stan23/tww-control/PCB/tww/tww_schematic_v1.1.pdf

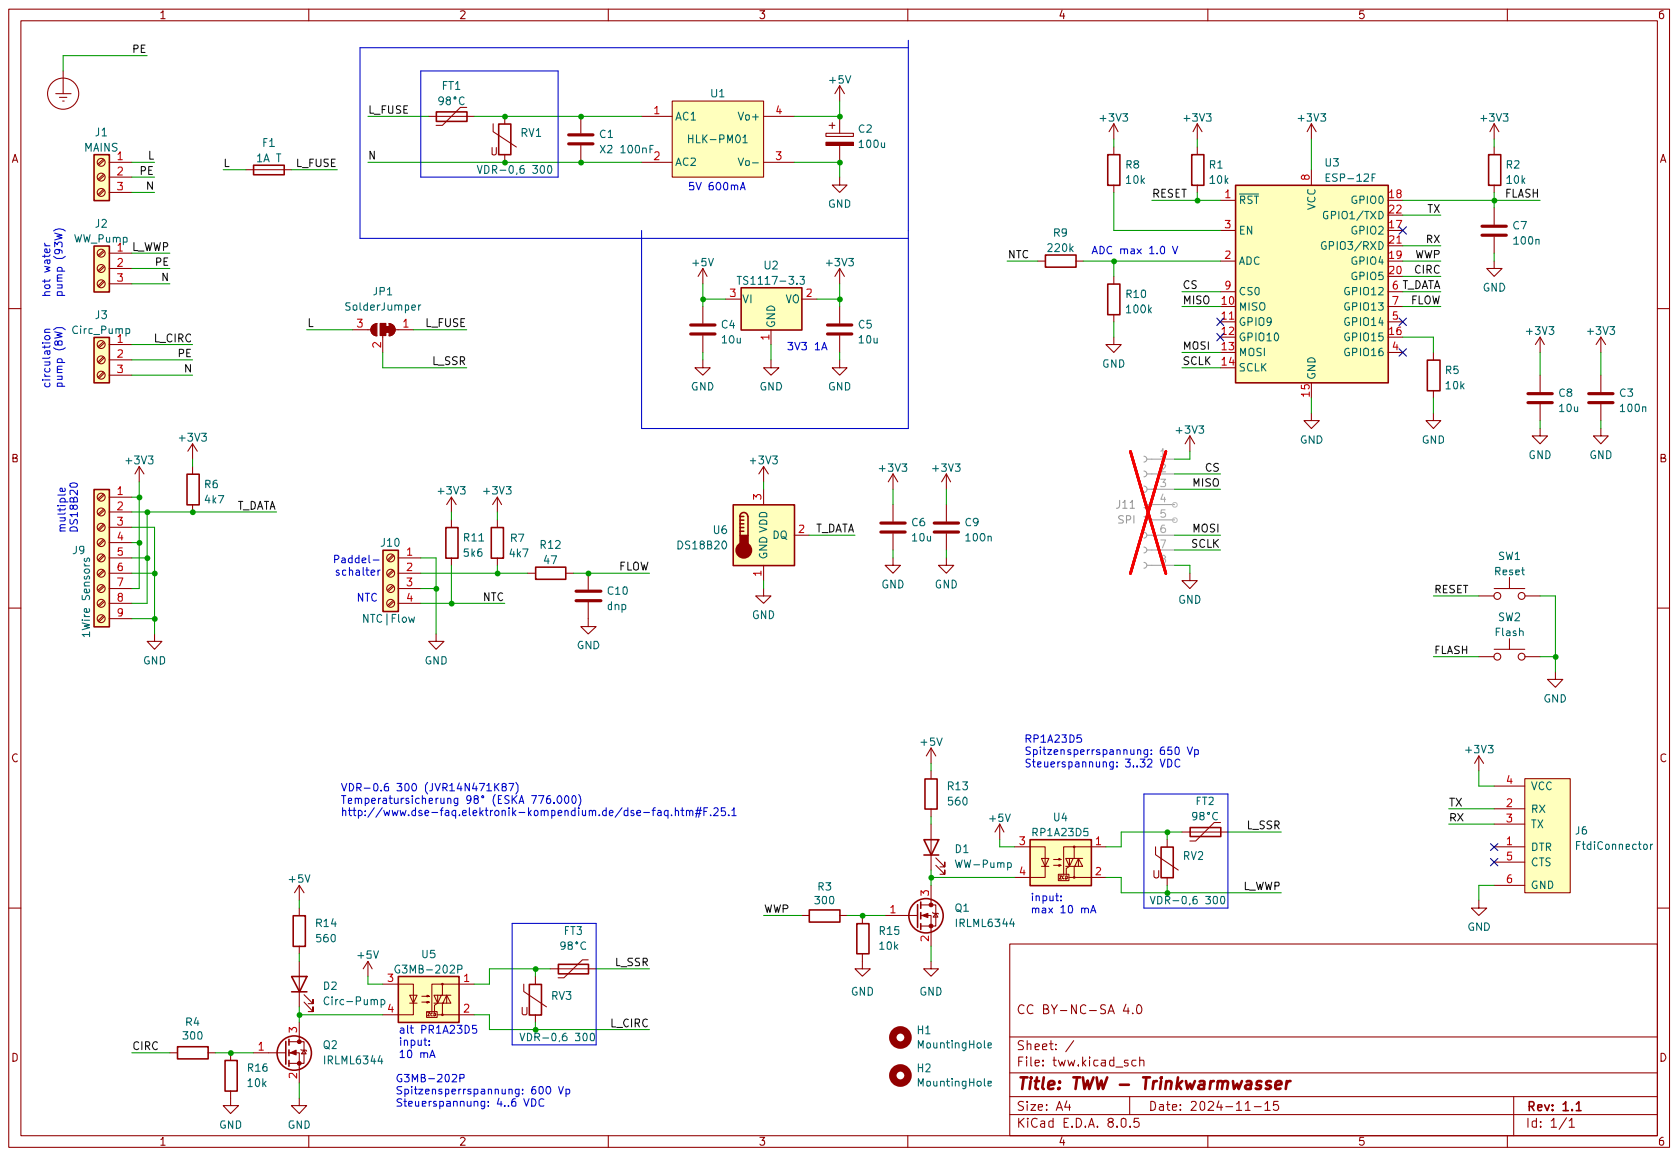
[picture p1: page 1]
