stan23/tww-control/PCB/tww/tww_pcb_bottom_v1.1.pdf

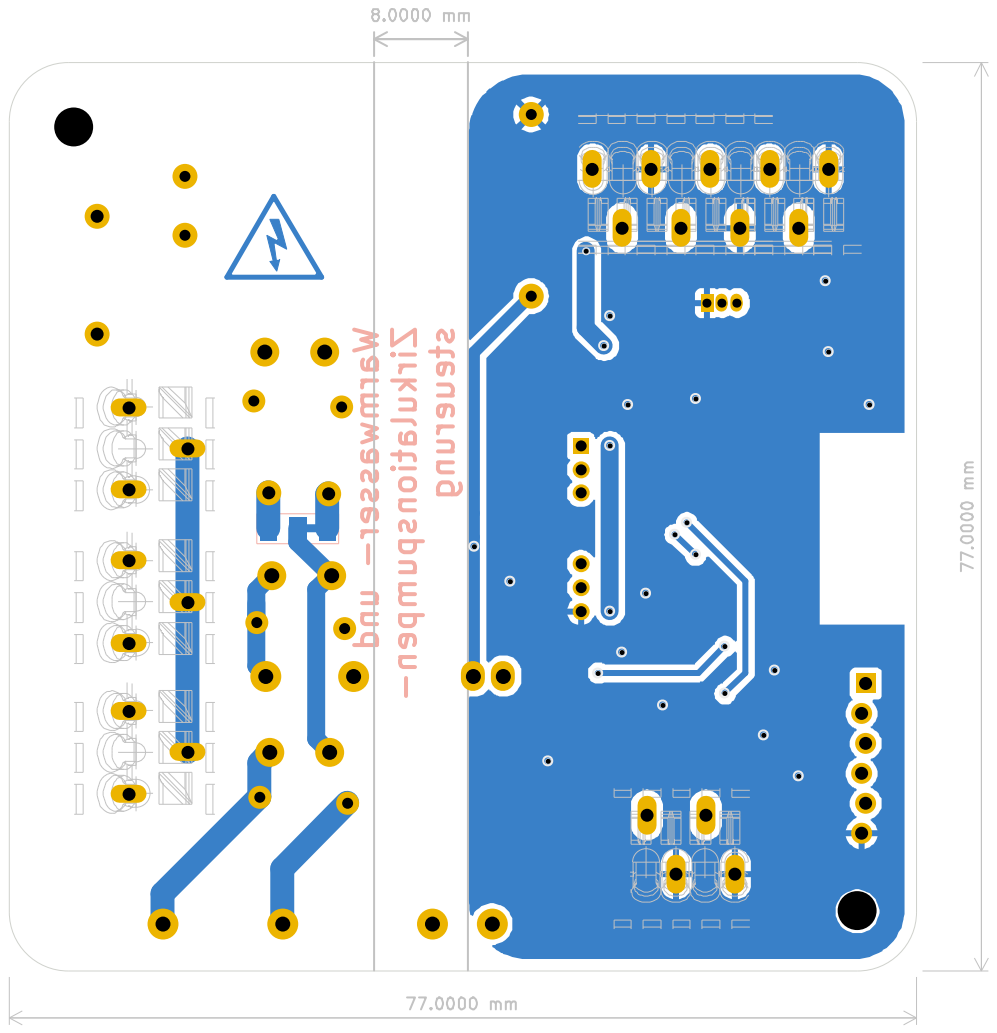
[picture p2: page 1]
