stan23/tww-control/PCB/tww/tww_pcb_top_v1.1.pdf

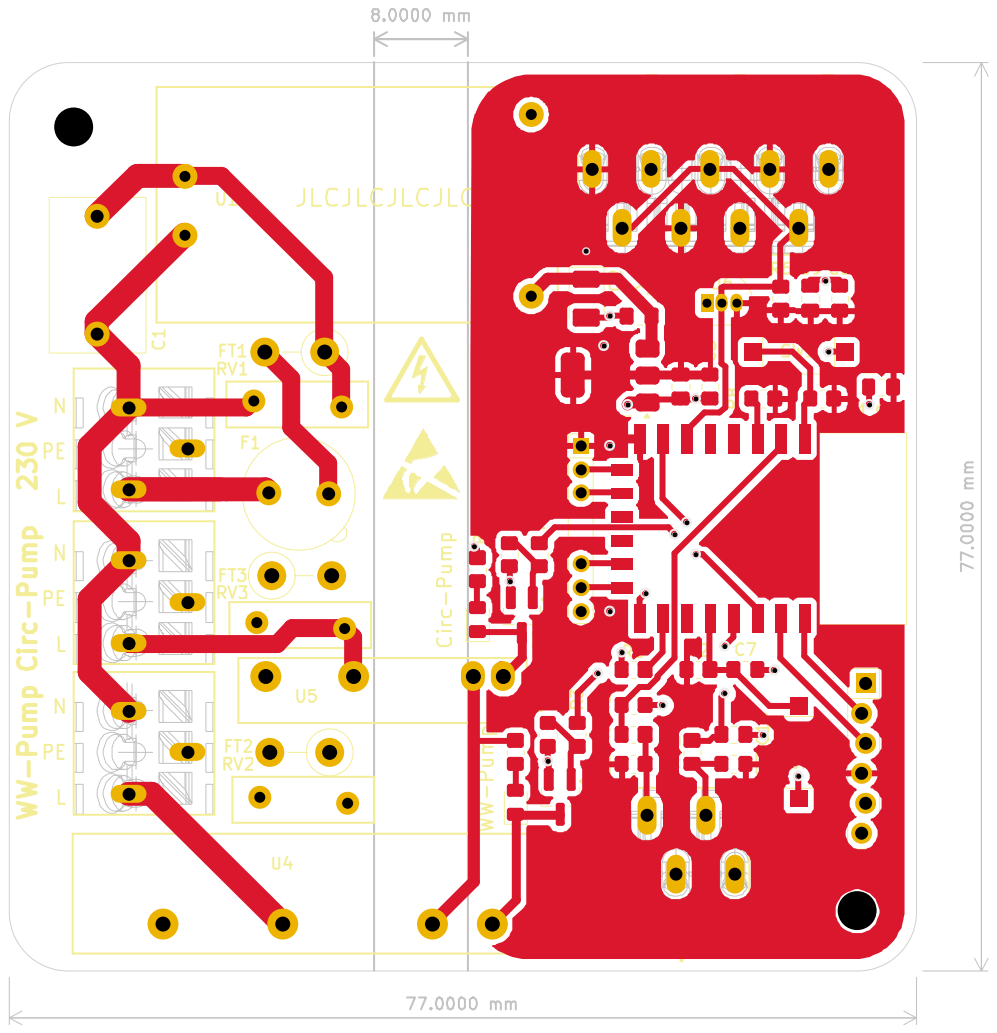
[picture p3: page 1]
