stan23/tww-control/PCB/tww/tww_schematic_v1.0.pdf

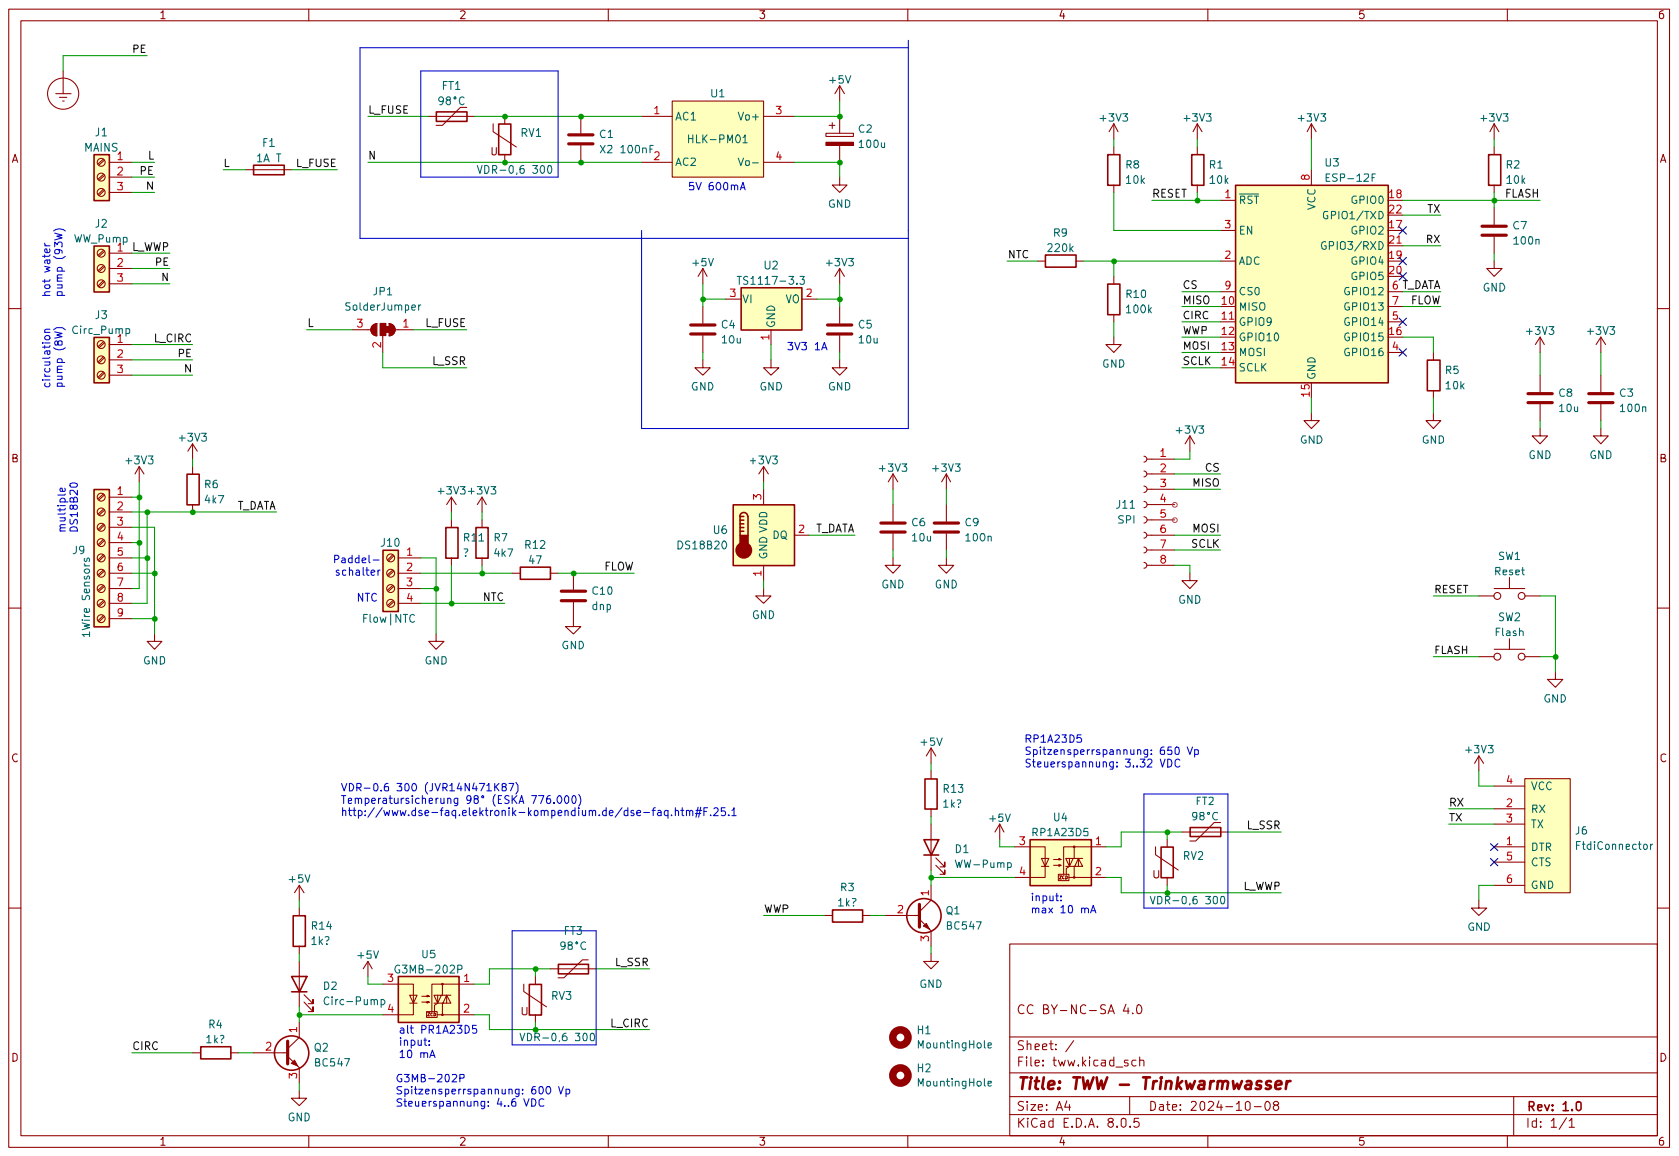
[picture p4: page 1]
