stan23/tww-control/PCB/tww/tww_pcb_bottom_v1.0.pdf

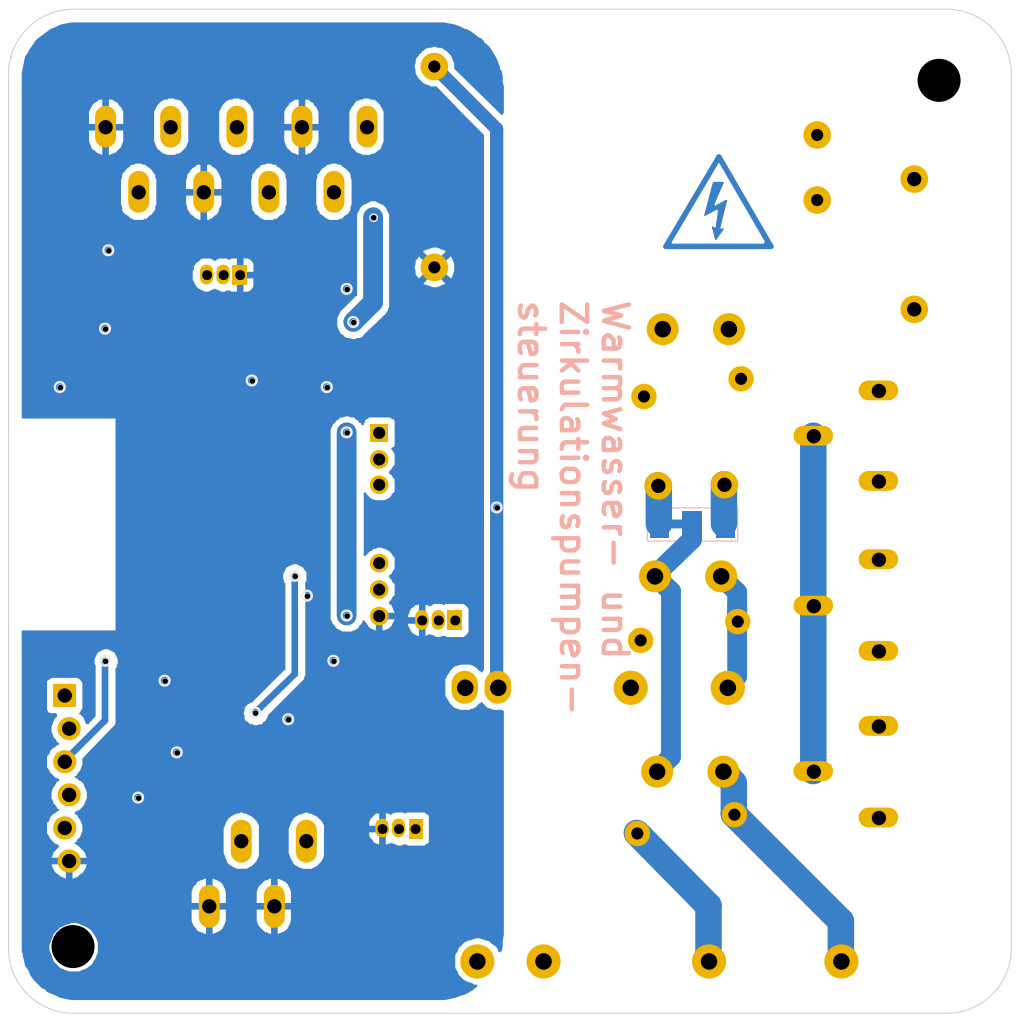
[picture p5: page 1]
