stan23/tww-control/PCB/tww/tww_pcb_top_v1.0.pdf

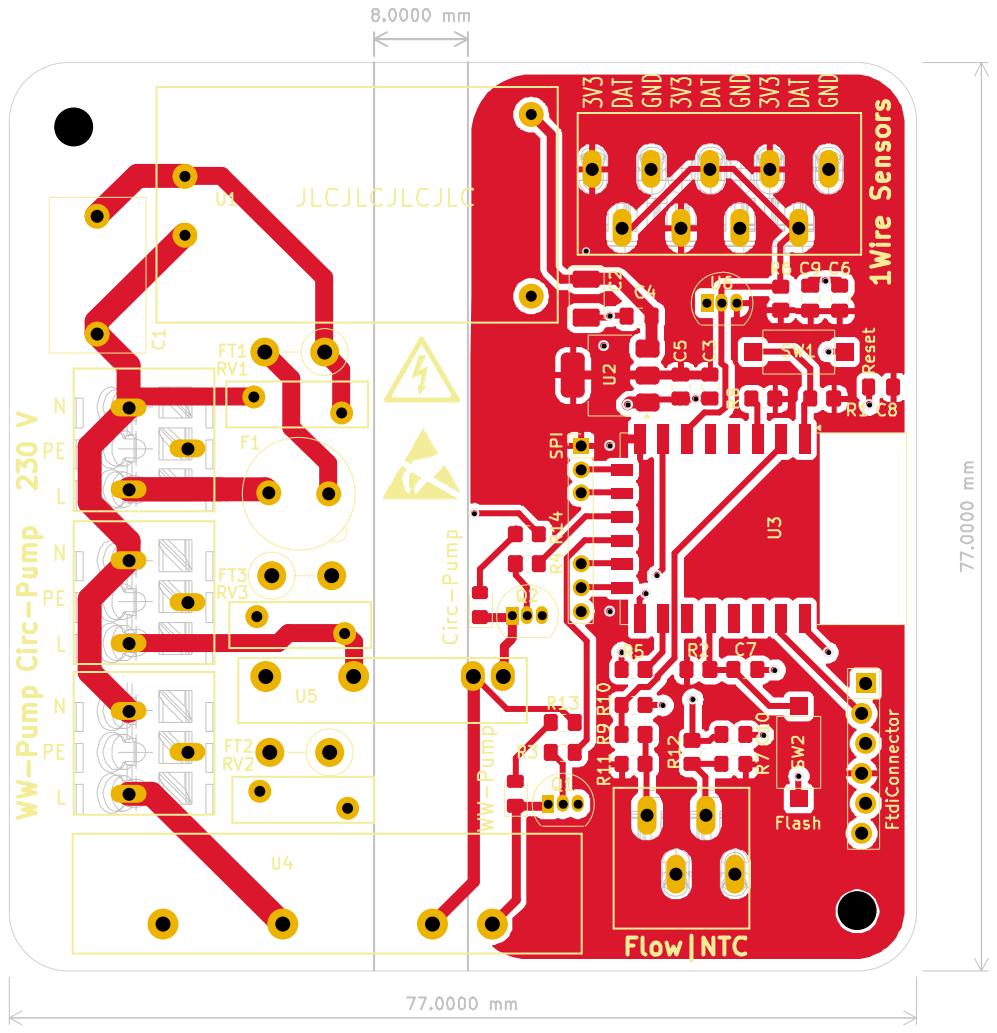
[picture p6: page 1]
