stan23/tww-control/PCB/tww/tww.kicad_pcb

## KiCad design PCB/tww/tww.kicad_pcb (2024-11-15)

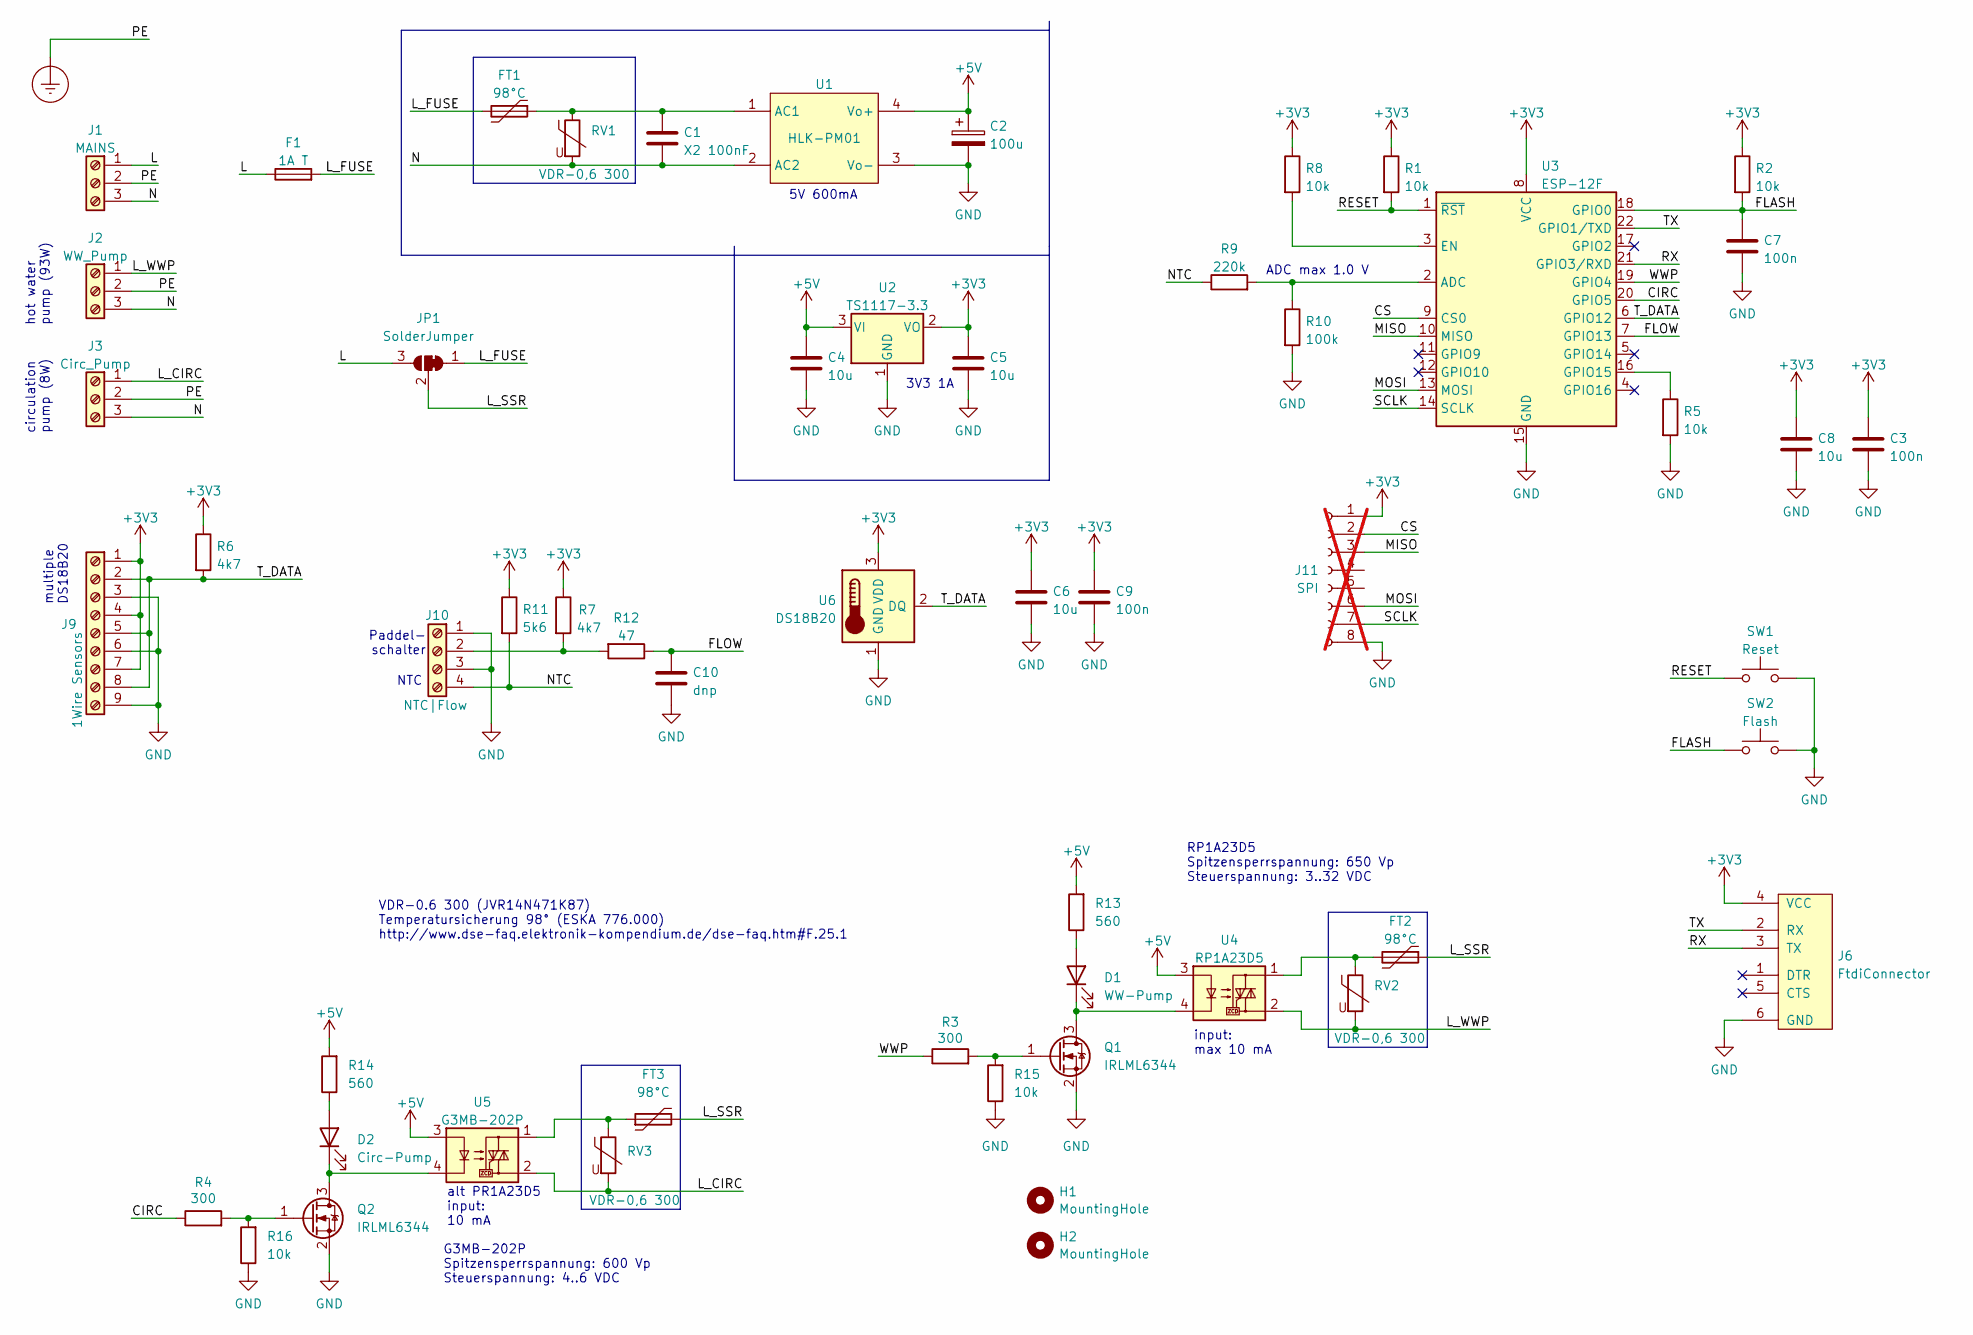
[picture p7: schematic tww.kicad_sch, TWW - Trinkwarmwasser]

Parts:
C1: X2 100nF; C_Rect_L13.0mm_W8.0mm_P10.00mm_FKS3_FKP3_MKS4
C2: 100u; CP_EIA-3528-12_Kemet-T_Pad1.50x2.35mm_HandSolder
C3, C7, C9: 100n; C_0805_2012Metric_Pad1.18x1.45mm_HandSolder
C4, C5, C6, C8: 10u; C_0805_2012Metric_Pad1.18x1.45mm_HandSolder
C10: dnp; C_0805_2012Metric_Pad1.18x1.45mm_HandSolder
D1: WW-Pump; LED_0805_2012Metric_Pad1.15x1.40mm_HandSolder
D2: Circ-Pump; LED_0805_2012Metric_Pad1.15x1.40mm_HandSolder
F1: 1A T; Fuseholder_TR5_Littelfuse_No560_No460
FT1, FT2, FT3: 98°C; R_Axial_DIN0411_L9.9mm_D3.6mm_P5.08mm_Vertical
H1, H2: MountingHole; MountingHole_3.2mm_M3
J1: MAINS; P-250-203
J2: WW_Pump; P-250-203
J3: Circ_Pump; P-250-203
J6: FtdiConnector; Pin_Header_Straight_1x06_Pitch2.54mm_Tight_Fit
J9: 1Wire Sensors; P-250-409
J10: NTC|Flow; P-250-404
J11: SPI; PinHeader_1x08_P2.00mm_Vertical; not fitted
JP1: SolderJumper; SolderJumper-3_P1.3mm_Bridged12_Pad1.0x1.5mm
Q1, Q2: IRLML6344; SOT-23_Handsoldering
R1, R2, R5, R8, R15, R16: 10k; R_0805_2012Metric_Pad1.20x1.40mm_HandSolder
R3, R4: 300; R_0805_2012Metric_Pad1.20x1.40mm_HandSolder
R6, R7: 4k7; R_0805_2012Metric_Pad1.20x1.40mm_HandSolder
R9: 220k; R_0805_2012Metric_Pad1.20x1.40mm_HandSolder
R10: 100k; R_0805_2012Metric_Pad1.20x1.40mm_HandSolder
R11: 5k6; R_0805_2012Metric_Pad1.20x1.40mm_HandSolder
R12: 47; R_0805_2012Metric_Pad1.20x1.40mm_HandSolder
R13, R14: 560; R_0805_2012Metric_Pad1.20x1.40mm_HandSolder
RV1, RV2, RV3: VDR-0,6 300; RV_Disc_D12mm_W3.9mm_P7.5mm
SW1: Reset; SW_SPST_CK_RS282G05A3
SW2: Flash; SW_SPST_CK_RS282G05A3
U1: HLK-PM01; Hi-Link_HLK-PMxx
U2: TS1117-3.3; SOT-223-3_TabPin2
U3: ESP-12F; ESP-12E
U4: RP1A23D5; Carlo_Gavazzi_RP1A
U5: G3MB-202P; Omron_G3MB
U6: DS18B20; TO-92_Inline

Connections:
+3V3: C3.1, C5.1, C6.1, C8.1, C9.1, J6.4 (VCC), J9.1, J9.4, J9.7, J11.1, R1.1, R2.1, R6.1, R7.1, R8.1, R11.1, U2.2 (VO), U3.8 (VCC), U6.3 (VDD)
+5V: C2.1, C4.1, R13.2, R14.2, U1.4 (Vo+), U2.3 (VI), U4.3, U5.3
/CIRC: R4.1, U3.20 (GPIO5)
/CS: J11.2, U3.9 (CS0)
/FLASH: C7.1, R2.2, SW2.1, U3.18 (GPIO0)
/FLOW: C10.1, R12.1, U3.7 (GPIO13)
/L: F1.1, J1.1, JP1.3 (B)
/L_CIRC: J3.1, RV3.2, U5.2
/L_FUSE: F1.2, FT1.2, JP1.1 (A)
/L_SSR: FT2.1, FT3.2, JP1.2 (C)
/L_WWP: J2.1, RV2.2, U4.2
/MISO: J11.3, U3.10 (MISO)
/MOSI: J11.6, U3.13 (MOSI)
/N: C1.2, J1.3, J2.3, J3.3, RV1.2, U1.2 (AC2)
/NTC: J10.4, R9.1, R11.2
/RESET: R1.2, SW1.1, U3.1 (~RST)
/RX: J6.3 (TX), U3.21 (GPIO3/RXD)
/SCLK: J11.7, U3.14 (SCLK)
/TX: J6.2 (RX), U3.22 (GPIO1/TXD)
/T_DATA: J9.2, J9.5, J9.8, R6.2, U3.6 (GPIO12), U6.2 (DQ)
/WWP: R3.1, U3.19 (GPIO4)
Earth_Protective: J1.2, J2.2, J3.2
GND: C2.2, C3.2, C4.2, C5.2, C6.2, C7.2, C8.2, C9.2, C10.2, J6.6 (GND), J9.3, J9.6, J9.9, J10.1, J10.3, J11.8, Q1.2 (S), Q2.2 (S), R5.2, R10.2, R15.1, R16.1, SW1.2, SW2.2, U1.3 (Vo-), U2.1 (GND), U3.15 (GND), U6.1 (GND)
unnamed: D1.2 (A), R13.1
unnamed: D1.1 (K), Q1.3 (D), U4.4
unnamed: D2.2 (A), R14.1
unnamed: D2.1 (K), Q2.3 (D), U5.4
unnamed: FT2.2, RV2.1, U4.1
unnamed: FT3.1, RV3.1, U5.1
unnamed: J10.2, R7.2, R12.2
unnamed: Q1.1 (G), R3.2, R15.2
unnamed: Q2.1 (G), R4.2, R16.2
unnamed: C1.1, FT1.1, RV1.1, U1.1 (AC1)
unnamed: R9.2, R10.1, U3.2 (ADC)
unnamed: R8.2, U3.3 (EN)
unnamed: R5.1, U3.16 (GPIO15)

Notes on the sheet:
hot water pump (93W)
VDR-0.6 300 (JVR14N471K87) Temperatursicherung 98° (ESKA 776.000) http://www.dse-faq.elektronik-kompendium.de/dse-faq.htm#F.25.1
input: max 10 mA
ADC max 1.0 V
3V3 1A
Paddel- schalter
alt PR1A23D5 input: 10 mA
G3MB-202P Spitzensperrspannung: 600 Vp Steuerspannung: 4..6 VDC
5V 600mA
NTC
RP1A23D5 Spitzensperrspannung: 650 Vp Steuerspannung: 3..32 VDC
circulation pump (8W)
multiple DS18B20

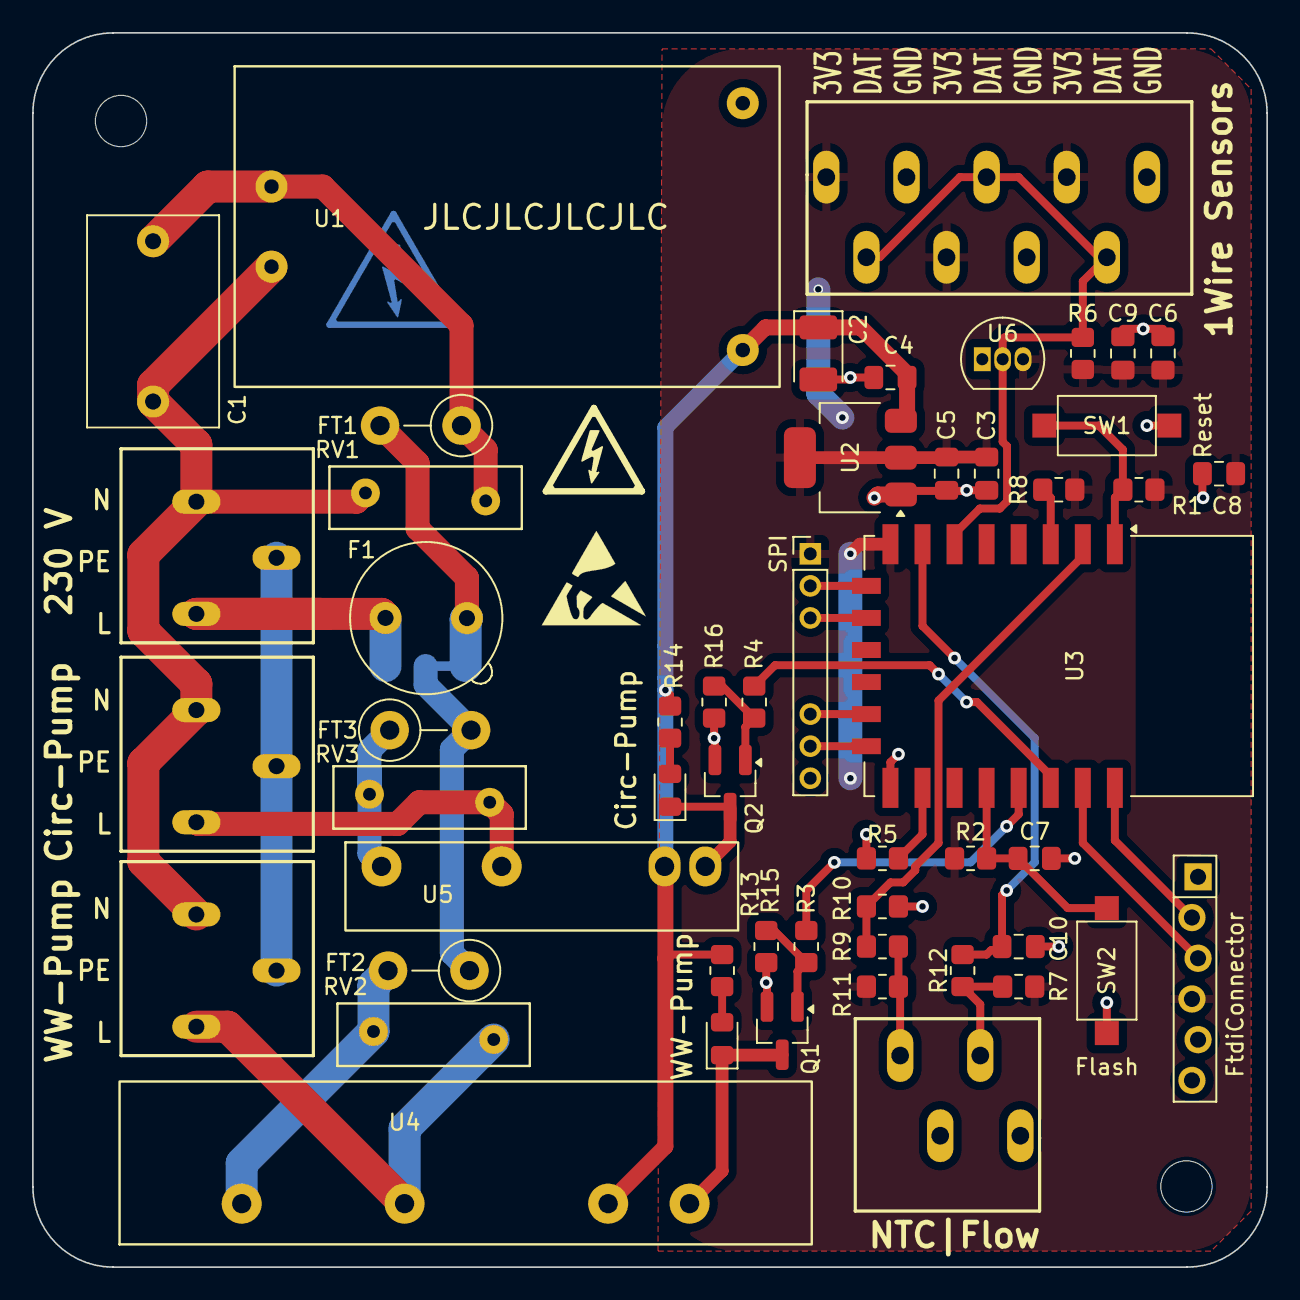
[picture p8: board tww.kicad_pcb from above]

Board: 2 copper layers, 77.0 x 77.0 mm, 55 parts (1 on the bottom side), 36 nets.
