stan23/tww-control/(threads)

Thread 1 (2024-10-21):

Bugs in PCB v1.0

stan23, 2024-10-21:
Bugs:

- U1 (HLK-PM01) output polarity swapped
- J6 (FtdiConnector): RX and TX swapped
- J10 label wrong

Improvements:

- VDR-0.6 footprint change

stan23, 2024-11-15:
fixed in 7a88bc7 and 148b277
