stan23/tww-control/(commit log)

2024-10-19 PCB version 1.0
    [tww.kicad_pcb, tww.kicad_sch]
2024-10-22 update to PCB v1.1
    addresses #1
    - U1 (HLK-PM01) output polarity swapped
    - J6 (FtdiConnector): RX and TX swapped
    - J10 label fixed
    - VDR-0.6 footprint changed
    - replaced BC547 by FET IRLML6344
    [tww.kicad_pcb, tww.kicad_sch]
2024-11-15 updates for PCB version 1.1
    - reconnect WWP and CIRC outputs
    [tww.kicad_pcb, tww.kicad_sch]
