stan23/tww-control/(notices)

Notices in the files:
PCB/tww/tww.kicad_pcb:
CC BY-NC-SA
PCB/tww/tww.kicad_sch:
CC BY-NC-SA 4.0
